ArnaudSaison/Takeo-Team-Projet-BA1/modèles 3D/Pepper dryer.stp

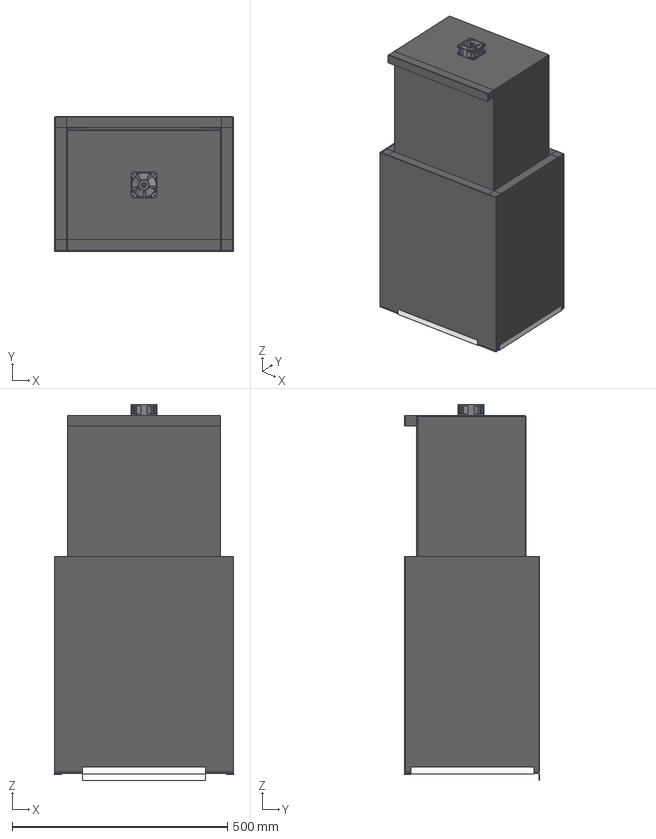
[picture p23: CAD file, 2019-03-17]
modèles 3D/Pepper dryer.stp
416.6 x 314.3 x 873.1 mm
largeur_s x 4
longueur_s x 4
hauteur_s x 4
plaque_s_dessous
plaque_s_latérale x 2
isolant_s_dessous
isolant_s_latéral x 2
plastique_s
paroi_fond
95844A350 x 176
profilé_guillotine x 4
traverses_plateaux
longueur_c x 4
hauteur_c x 4
largeur_c x 4
plaque_c_latérale x 2
plaque_c_dessous
isolant_c_latéral x 2
isolant_c_dessous
plastique_c
paroi_avant
support
niveau_support
clou_long x 12
ventilateur
profilé_largeur x 4
profilé_longueur x 4
grille x 2
