ArnaudSaison/Takeo-Team-Projet-BA1/(list of files, cad)

Other CAD files:
modèles 3D/Pepper dryer.f3z
