ArnaudSaison/Takeo-Team-Projet-BA1/(commit log)

2018-11-04 Code du bloc effet de serre
    Il faut encore déterminer h
2018-11-05 Version corrigée
    Précision Celsius <=> Kelvin
    Ajout d'une autre méthode de résolution identique : je ne sais pas laquelle est la meilleure.
2018-11-13 Implémentation des équations du h
2018-11-20 Juste un peu de nettoyage pour rendre plus lisible
2018-11-21 Ajouts et corrections
    équation de la distance caractéristique
    modifications des valeurs de départ
    ajout de la constante gravitationnelle par sciPy
2018-11-21 ajout du Y et des unités
2019-02-13 Mise jour après mi-parcour
    L'interface console est utilisable.
    Ajout d'un mode labo.
    /!\ il reste quelque part un problème dans les équations ou conversions d'input qui fait que les outputs ne sont pas corrects
2019-03-06 Correction de l'erreur de conversion de HRmax
    On utilisait la température ambiante pour calculer Ymax.
    => inversion du delta Y, puisque Ymax = eau contenue dans l'air + eau évaporée
2019-03-06 Clarification de l'affichage
    couleurs
    débit en m/s (calcul à vérifier)
    indicateur de validité du nombre de Rayleigh (à vérifier)
2019-03-06 Ajout de couleurs
